bluesberyyajm1966/kratos/README.md

# kratos
This is my custom coreXY 3d printer, I have spent the last 6 months designing this, it has triple z independant lead screws for automatic bedleveling and it has 3d printed mounts.s
