bluesberyyajm1966/kratos/pictures/Corner idler front picture.jpg

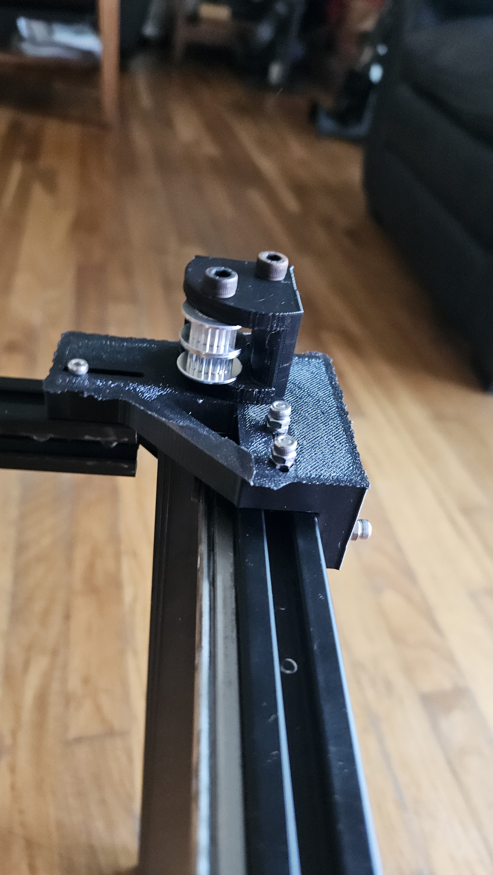
pictures/Corner idler front picture.jpg
