bluesberyyajm1966/kratos/pictures/Corner idler picture.jpg

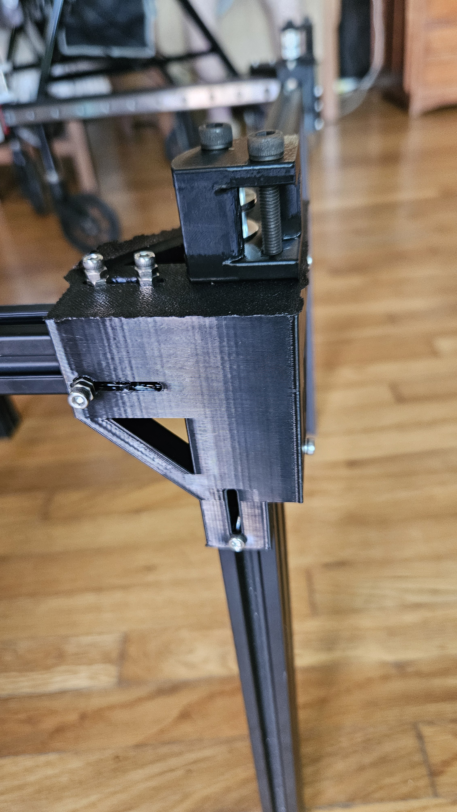
pictures/Corner idler picture.jpg
