bluesberyyajm1966/kratos/pictures/Corner motor mount picture.jpg

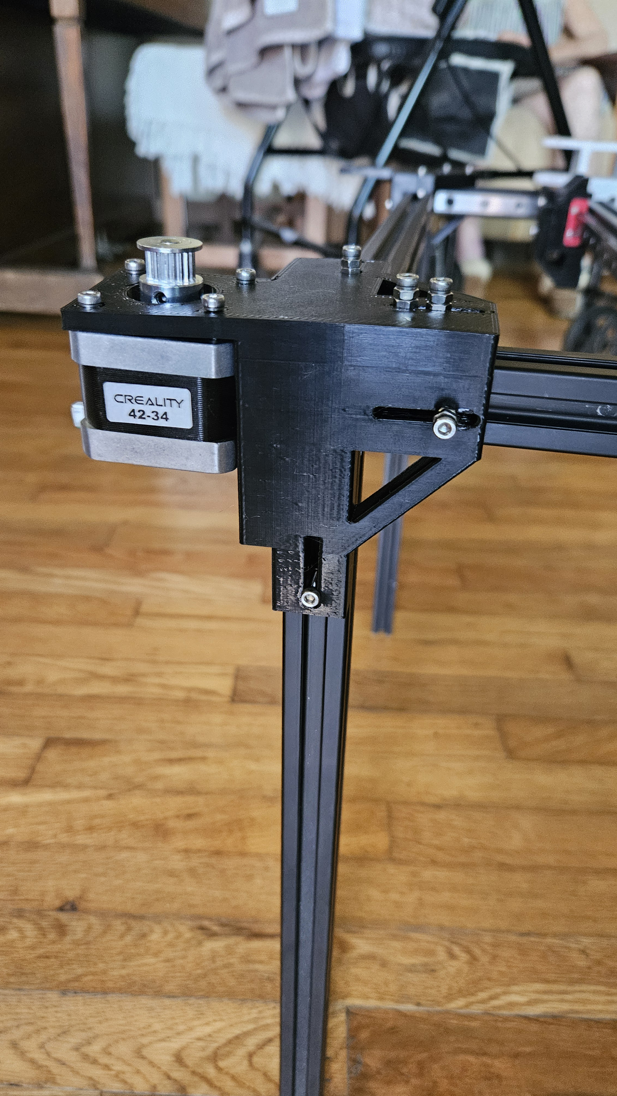
pictures/Corner motor mount picture.jpg
