bluesberyyajm1966/kratos/bom.md

# Kratos CoreXY - Bill of Materials (BOM)

---

### 1. Frame, Bed Structure & Hardware

| Item Description | Qty Needed | Grant Cost | Status / Source Link |
| :--- | :---: | :---: | :--- |
| **2020 Aluminum Extrusions (400mm)** | 4 | **$0.00** | Already Owned |
| **2020 Aluminum Extrusions (400mm, 8-Pack)** | 1 Pack | **$29.00** | [Amazon Link](https://www.amazon.com/dp/B0DY7HXV9C) *(5 used for frame, 3 spare stock)* |
| **2040 Aluminum Extrusions (400mm)** | 4 | **$0.00** | Already Owned |
| **2040 Aluminum Extrusions (400mm, 4-Pack)** | 1 Pack | **$24.00** | [Amazon Link](https://www.amazon.com/dp/B09LQJ3PJ5) *(4 needed for main frame)* |
| **Bed Support Extrusions (2020 / Aluminum Profiles)** | 1 Set | **$0.00** | Already Owned |
| **M3 / M4 / M5 Fasteners & T-Nut Assortments** | 1 Kit | **$0.00** | Already Owned |
| **Heat-Set Threaded Inserts (M3 Assortment)** | 1 Pack | **$0.00** | Already Owned |
| **SUBTOTAL FRAME & HARDWARE:** | | **$53.00** | |

---

### 2. Motion System & Kinematics

| Item Description | Qty Needed | Grant Cost | Status / Source Link |
| :--- | :---: | :---: | :--- |
| **MGN12H Linear Guide Rails with Blocks (400mm)** | 3 | **$0.00** | Already Owned |
| **MGN9H Linear Guide Rails with Blocks (300mm)** | 3 | **$21.00** | [Amazon Link](https://www.amazon.com/dp/B0BXWQHW7G) |
| **GT2 Timing Belt, 20T Pulleys & Toothless Idlers** | 1 Kit | **$0.00** | Already Owned |
| **T8 Lead Screws with Anti-Backlash Nuts (300mm, 2-Pack)** | 2 Packs | **$30.00** | [Amazon Link](https://www.amazon.com/dp/B0GZZ4R4X5) *(3 used for Triple-Z, 1 spare)* |
| **Flexible Shaft Couplers 5mm to 8mm (2-Pack)** | 2 Packs | **$24.00** | [Amazon Link](https://www.amazon.com/dp/B0GS2YKMP3) *(3 used for Triple-Z, 1 spare)* |
| **PATIKIL M4 x 10mm Stainless Steel Ball Nuts (3-Pack)** | 1 Pack | **$7.00** | [Amazon Link](https://www.amazon.com/dp/B0FBS22YBM) *(Used for Kinematic Bed Mounts)* |
| **N52 Countersunk Ring Magnets 12x3mm (40-Pack)** | 1 Pack | **$23.00** | [Amazon Link](https://www.amazon.com/dp/B0GF1X7XL2) *(Kinematic Mounts / Toolhead Docking)* |
| **GE5C Spherical Bearings 5x14x6mm (4-Pack)** | 1 Pack | **$9.00** | [Amazon Link](https://www.amazon.com/dp/B0CRNQYDFN) *(3 used for Kinematic Bed, 1 spare)* |
| **SUBTOTAL KINEMATICS:** | | **$156.00** | |

---

### 4. Electronics, Power & Host Hardware

| Item Description | Qty Needed | Grant Cost | Status / Source Link |
| :--- | :---: | :---: | :--- |
| **BigTreeTech Octopus Pro v1.1 + TMC Drivers** | 1 | **$0.00** | Already Owned |
| **NEMA 17 Stepper Motors (CoreXY + Triple Z)** | 6 | **$0.00** | Already Owned |
| **BIGTREETECH CB1 V2.2 + Pi4B Adapter Board Kit** | 1 | **$40.00** | [Amazon Link](https://www.amazon.com/dp/B0BLN8VCVN) *(Klipper Host Controller)* |
| **Mean Well LRS-350-24 Power Supply (24V 14.6A)** | 1 | **$32.00** | [Amazon Link](https://www.amazon.com/dp/B09K5MS2FB) |
| **SUBTOTAL POWER & HOST:** | | **$72.00** | |

---

### 5. Primary Toolhead Assembly (Voron Stealthburner Architecture)

| Item Description | Qty Needed | Grant Cost | Direct Product Link |
| :--- | :---: | :---: | :--- |
| **Bambu Lab X1C Complete Hotend Assembly (0.4mm Hardened Steel / 24V)** | 1 | **$35.00** | [3DJake Product Link](https://www.3djake.com/bambu-lab/complete-hotend-x1c) |
| **Voron Clockwork 2 (CW2) BMG Drive Gear Kit (Bondtech IDGA)** | 1 | **$18.00** | [Filastruder Product Link](https://www.filastruder.com/products/bmg-integrated-drive-gear-assembly-idga-retrofit-kit-sku-15169) |
| **LDO NEMA 14 36mm Pancake Stepper Motor (LDO-36STH20-1004AHG)** | 1 | **$21.00** | [West3D Product Link](https://west3d.com/products/ldo-nema14-36mm-pancake-stepper-motor-ldo-36sth20-1004ahg) |
| **5015 Blower Fan (24V Dual Ball Bearing)** | 1 | **$7.00** | [Etsy Product Link](https://www.etsy.com/listing/4419541090/24v-5015-blower-fan-2-pin-jst-connector) |
| **Stealthburner Structural Bodies & Faceplates (Printed in ASA)** | 1 Set | **$0.00** | Self-Provided *(Printed using existing 3D printer)* |
| **SUBTOTAL TOOLHEAD:** | | **$81.00** | |

---

### Budget Summary & Funding Breakdown

| Category | Total Required |
| :--- | :---: |
| **1. Frame, Bed Structure & Hardware** | **$53.00** |
| **2. Motion System & Kinematics** | **$114.00** |
| **3. Heated Bed System** | **$237.00** |
| **4. Power & Host Controller** | **$72.00** |
| **5. Toolhead Assembly** | **$81.00** |
| **TOTAL REMAINING HARDWARE NEEDED:** | **$557.00** |
