bluesberyyajm1966/kratos/pictures/Archived kratos.step

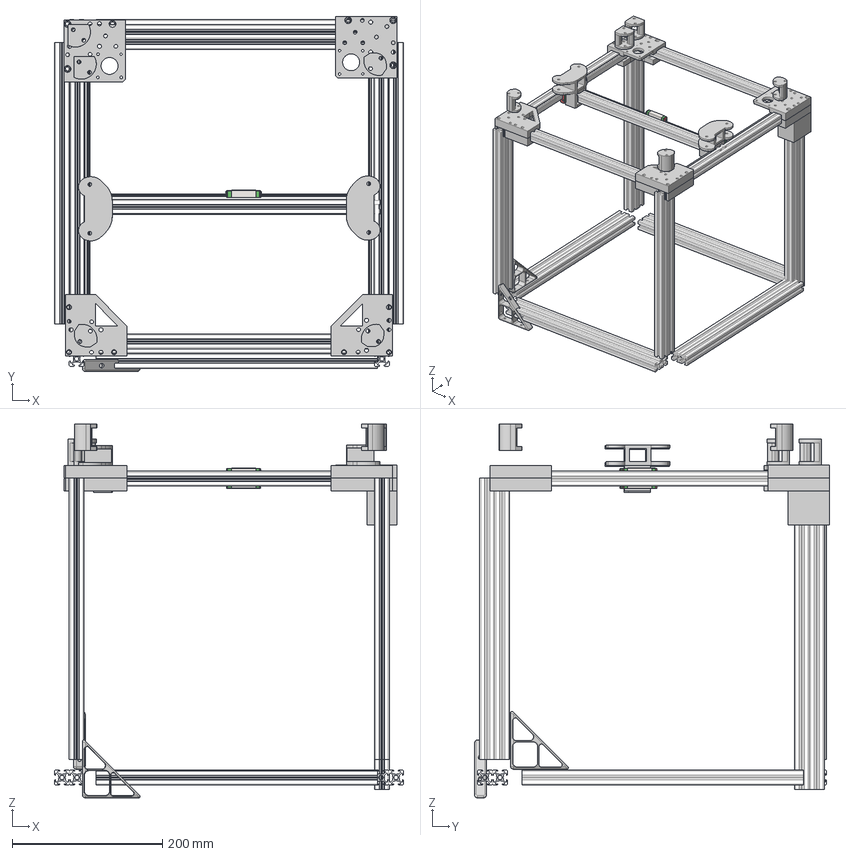
[picture p4: CAD file, 2026-07-25, an earlier design]
pictures/Archived kratos.step
465.0 x 472.9 x 498.0 mm
20x20 x 5
MGN12H_Body x 3
MGN12H_EndCap x 6
MGN12H_Seal x 6
MGN12H_Cage x 6
MGN12H_Ball x 102
MGNR12R100HM x 3
20x20_1 x 8
20x20_2 x 8
GT2 Pulley 20T 5R x 2
Corner motor mount x 2
NEMA 17 3D Model x 2
idler mount x 3
connection 1
connection 2
Creality Ender 5 Plus Gussets x 2
Corner x 2
20x40 connect 1
idler mount_1 x 2
