bluesberyyajm1966/kratos/(commit log)

2026-07-25 Rename Archived kratos.step to Cad/Archived kratos.step
    [Archived kratos.step]
2026-07-25 Rename Cad/Archived kratos.step to Cad/Archive/Archived kratos.step
    [Archived kratos.step]
2026-07-25 Rename Corner idler front picture.jpg to image/Corner idler front picture.jpg
2026-07-25 Rename 3d printer frame picture.jpg to image/3d printer frame picture.jpg
2026-07-25 Rename Corner idler picture.jpg to image/Corner idler picture.jpg
2026-07-25 Rename Corner motor mount picture.jpg to image/Corner motor mount picture.jpg
2026-07-25 Update 3d printer frame picture.jpg
2026-07-25 Rename New corner mount.jpg to New corner mount design.jpg
2026-07-25 Rename New corner mount design.jpg to New corner mount.jpg
