bluesberyyajm1966/kratos/pictures/Old corner mount.jpg

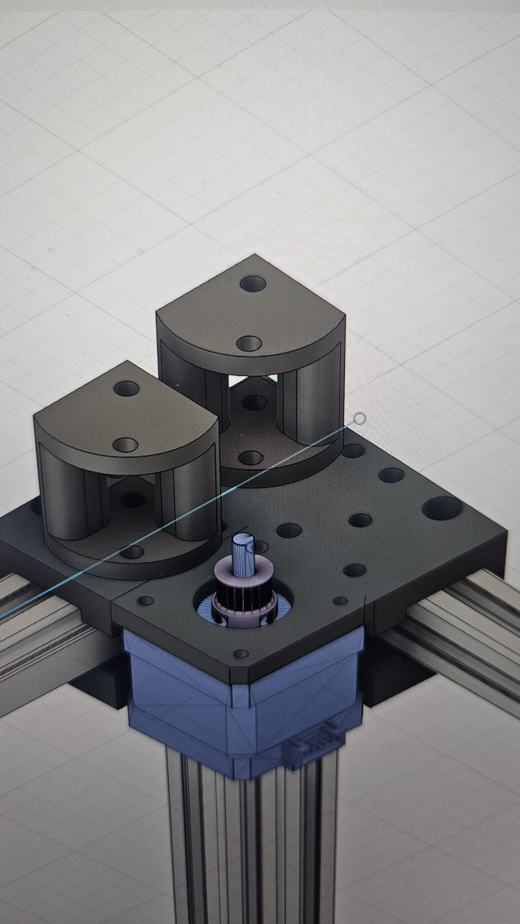
[picture p7: pictures/Old corner mount.jpg]
pictures/Old corner mount.jpg
