bluesberyyajm1966/kratos/pictures/New corner mount.jpg

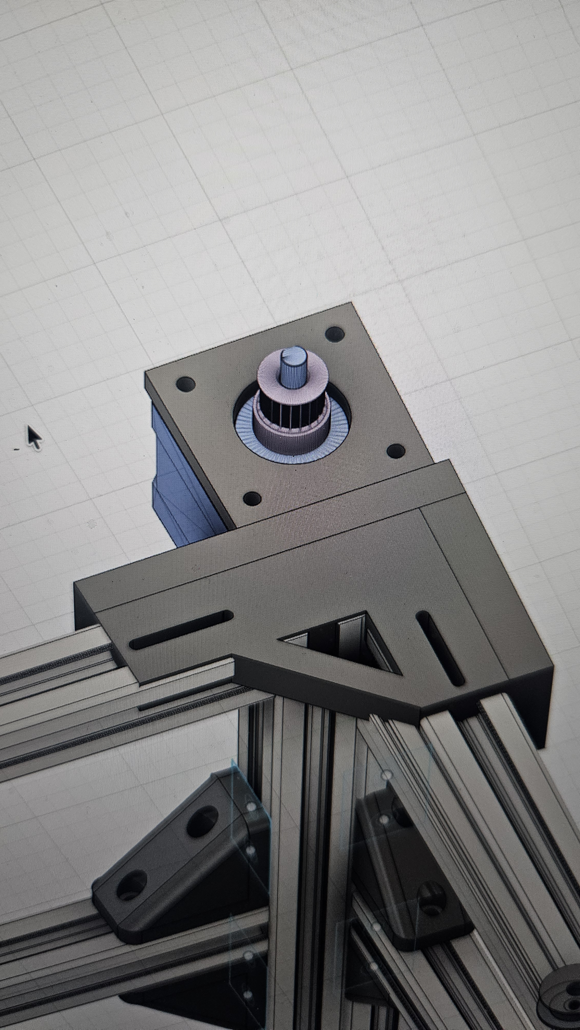
[picture p8: pictures/New corner mount.jpg]
pictures/New corner mount.jpg
