bluesberyyajm1966/kratos/pictures/3d printer frame picture.jpg

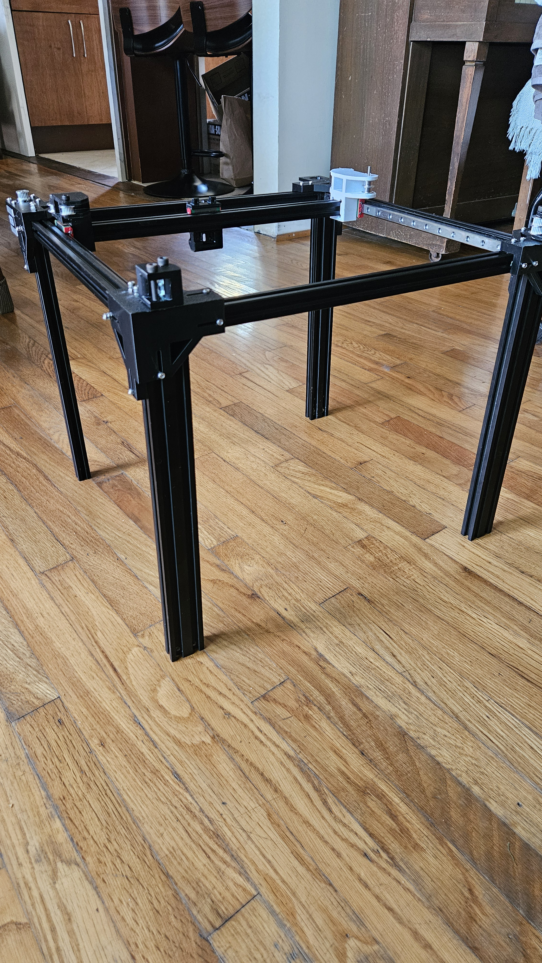
pictures/3d printer frame picture.jpg
